f1iwq2/Tetra_Link_boardIWQ/README.md

# Tetra_Link_boardIWQ
 Tetra board for the Pi Svxlink-tetra
 Kicad Electronic Schematics & documentation
 
 Carte Tetra pour le Pi
 Schémas Kicad & documentation
 
 image::interface_MTM800E_V4.jpg[]
