f1iwq2/Tetra_Link_boardIWQ/Doc/assembly tetralink board V4 instr.pdf

## SVXLINK TETRA LINK V4 F1IWQ 31/08/2021 board assembly instructions

This card is intended for the Raspberry Pi3B+ running with the svxlink software. It interfaces the Motorola TETRA MTM800(E) or MTM5x00 radio stations series. It allows dialogs using RS232 operating mode with the MTM. The SQ (COS) signal from the MTM800 can be picked up inside the station, or be fetched by AT commands using the UART of the Pi. For this feature, you must use the tetra-contrib branch from DL1HRC. The board has a speaker terminal block for the MTM and a speaker terminal block for listening locally the radio and the audio network channels. The board is double-sided screen-printed and metallized holes, with a double ground plane.

## Description of terminal blocks, jumpers and settings

J2.1 = TxAud is the audio signal from the sound card from the pi to the sound input to the station J2.2 = RxAud is the audio signal from the radio to the sound card to the pi (mic)
J2.3 = 0V
J2.4 = NC
J2.5 = Squelch from the radio. On the MTM800E, the signal must be fetched on pin 8 on the TDA (access to the GPS hatch). See note below.
J2.6 = 0V
An audio cable must be made to connect the sound card (SP-MIC) to terminal block J2. If you use the TETRA branch of svxlink and enable TETRALOGIC, you don't need to wire J2.5 (SQ)

J3: connector to MTM800 (E)

J4: routing capacitor. J4 is to be bridge with a 1µF capacitor between 1-2 or between 2-3 depending on the impedance (level) of the audio signal injected into the radio. Normally, you have to use an external sound card with the raspberry plugged into one of its USB ports ; J4.2 and J4.3 are bridged together (use EXTMICAUD). See note at the end.

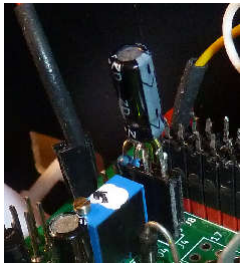
[picture p62: figure]

Capacitor soldered on pinout J4.2 and J4.3. A capacitor is required to avoid grounding bias from MTM radio through the RV1 resistor.

6 and J7: routing for UART from MTM800 / 5X00 (Rx and Tx) to Raspberry or DB9.
These two end-pins are used to route the signals from the UARTs of the MTM800 / MTM5x00 to the raspberry or the DB9.

For an MTM800E, place a jumper on J6.3 and J6.4 and a strap on J7.3 and J7.4 to redirect the UART to the raspberry pi, to be used with SVXLINK.

For an MTM5x00, this depends on the control head (control head connected to the station) see paragraph Specific features for the PEI interface using MTM5x00 on page 5.

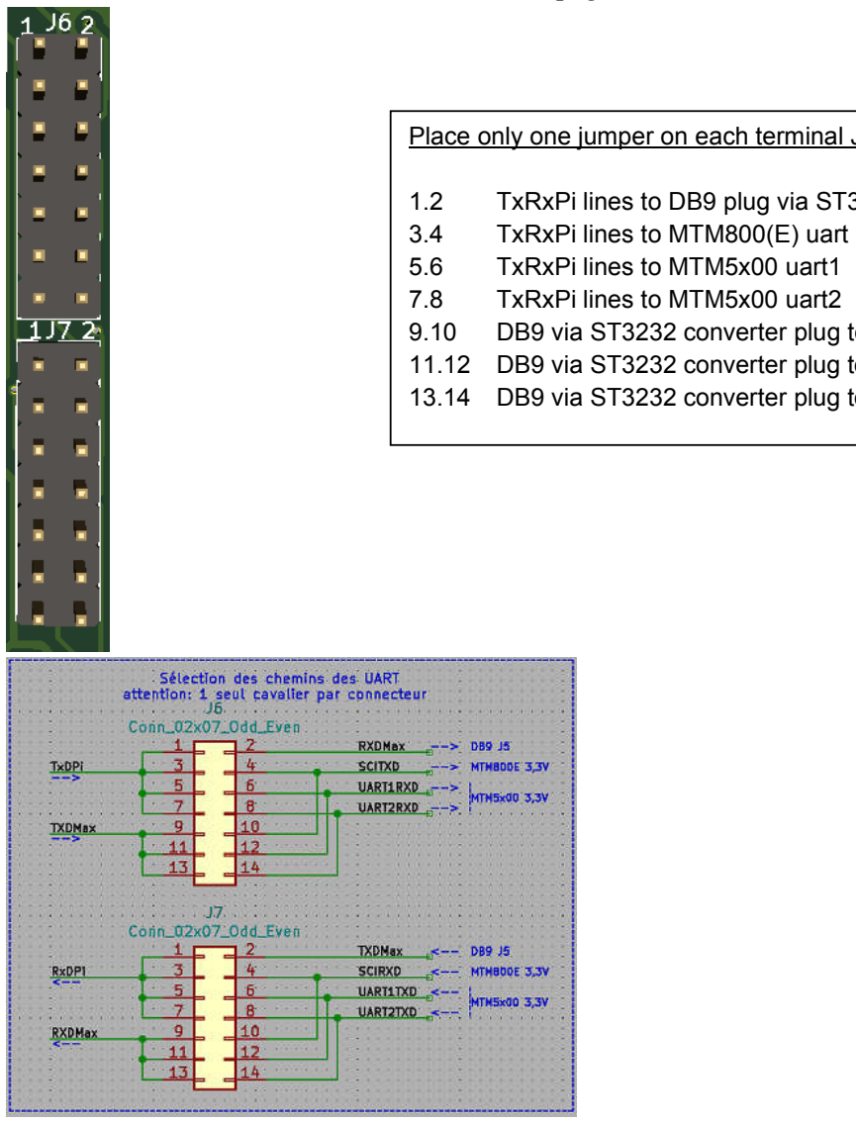
[picture p63: figure]
TxRxPi lines to MTM800(E) uart; TxRxPi lines to MTM5x00 uart1; TxRxPi lines to MTM5x00 uart2

You must not both connect an MTM800 and an MTM5x00 to the interface. Connect only one jumper per terminal J6/J7.

The MTM800 only has one UART. It can be redirected to the DB9 front face or to the raspberry. The MTM5x00 has 2 UARTs.

Please read the specific part for MTM5x00

Place only one jumper on each terminal J6/J7

1.2 | TxRxPi lines to DB9 plug via ST3232 converter
9.10 | DB9 via ST3232 converter plug to MTM800(E)
11.12 DB9 via ST3232 converter plug to MTM5x00 uart1 13.14 DB9 via ST3232 converter plug to MTM5x00 uart1

J8: pin to pin straight connector to the MTM5400

J9: bridge J9 (DTR-DSR bridge) to use the RS232 DB9 interface.

J10 and J11: see JP1 and JP2

J12: used to supply the raspberry with 5V instead of going through the usb power supply to the raspberry. Beware of the polarity.

J13 (HP-MTM) is the listening speaker of the MTM800-5x00 (HP + HP-)

J14, if it not bridged then disables the keyer to the MTM using EXTERNAL_PTT. To bridge if using a MTM5x00 in DMO repeater mode. Restriction : on the MTM5x00, if the DMO Repeater mode is used, it is not possible to use the PEI interface to key the transmiter on. You must use the PTT wired via GPIO16 and modify the Rx section accordingly.

J15 (HP1) is a terminal block for a speaker listening locally from the radio or the network.

J16 (ignition) to be connected to external 12V to automatically start the MTM as soon as the power is switched on. Switching this pin to 0V will turn off the MTM. This pin is therefore to be connected to the general 12V power supply.

J17 : RTS signal from UART1 to the MTM5x00 connector.

JP1: bridge JP1 to connect the PTT to GPIO16 of the raspberry.
Otherwise PTT is available on J10: solder a wire between J10 and the desired GPIO of the pi.

JP2: bridge JP2 to connect SQ3 (COS) to GPIO19 of the raspberry
Otherwise SQ3 is available on J11: solder a wire between J11 and the desired GPIO of the pi.

RV1: adjustment of the audio injected into the radio
RV2: adjustment of the audio received from the radio to the sound card
RV3: adjustment of the voltage switching point for the comparator LM311 (adjust to have 8.25V on terminal 3 of U1). This voltage is used to switch if the squelch signal goes from 4.5V to 12V: U1.7 = 3V if U1.2 = 12V RV4: setting from the sound card audio output (network monitoring) to the local monitoring speaker on terminal block J15
RV5: audio adjustment for the audio output from the MTM (radio listening) to the speaker of the local listening on terminal block J15.

The DB9 is in the RS232 standard; it is used in operating mode (AT commands)

Cable made for SVXLINK board to MTM800E (J3) or MTM5x00 (J6)
You just need to make a straight cable. You can also use an HE10 20/26 points straight female-female ribbon. Pay attention to the direction of the connector when plugin. For MTM5x00 depending of the front head connected to the body station, you don't need the PEI signal lines on the J6 terminal. See below.

Using RS232
The RS232 serial link allows to use the AT commands when the MTM is running. The default settings are 9600 bauds, no parity, 1 start bit 1 stop bit, without RTS / CTS protocol according to the CPS settings. You can use an RS232 / USB converter to the PC.

Note: to manage the squelch signal, it is possible to use the MTM AT commands controlled from the Pi, using a software function.

## Specific features for the PEI interface using MTM5x00 series

The PEI interfaces for MTM5x00 stations series are routed either to the rear connector or to a DB9 depending on the "control head" connected to the station.

### MTM5200 and MTM5400

If the station body (brick) is connected to a PMLN4904 "control head", then the PEI interface is available on the rear connector. It is at the 3.3V level. Use direct link on the board.

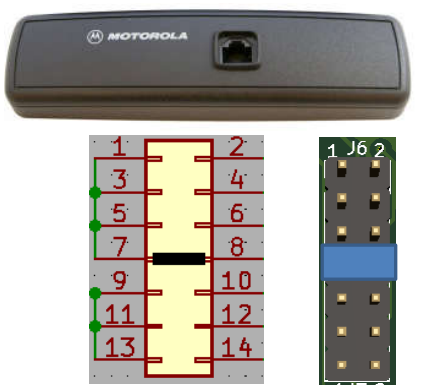
[picture p64: figure]

If the station body (brick) is connected to a PMLN4908 "data expansion head", then the PEI interface is redirected to the front DB9 on the data expansion head. (MTM5500). It complies with RS232 V24 standards and can be connected to a serial COM port to a PC directly.

Control head
PMLN4904

Strap position for
J6 et J7:
J6.7 - J6.8
J7.7 - J7.8
Using UART2

Data expansion head
PMLN4908

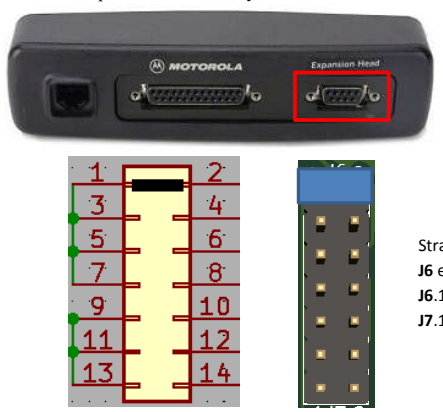
[picture p65: figure]

Strap position for
J6 et J7 :
J6.1 - J6.2
J7.1 - J7.2

## MTM5500

The station body (brick) is to be connected to an "ethernet expansion control head" PMLN7009 and the PEI interface is redirected to the front DB9 on the ethernet remote control head. It complies with RS232 V24 standards and can be connected to a COM port to a PC directly.

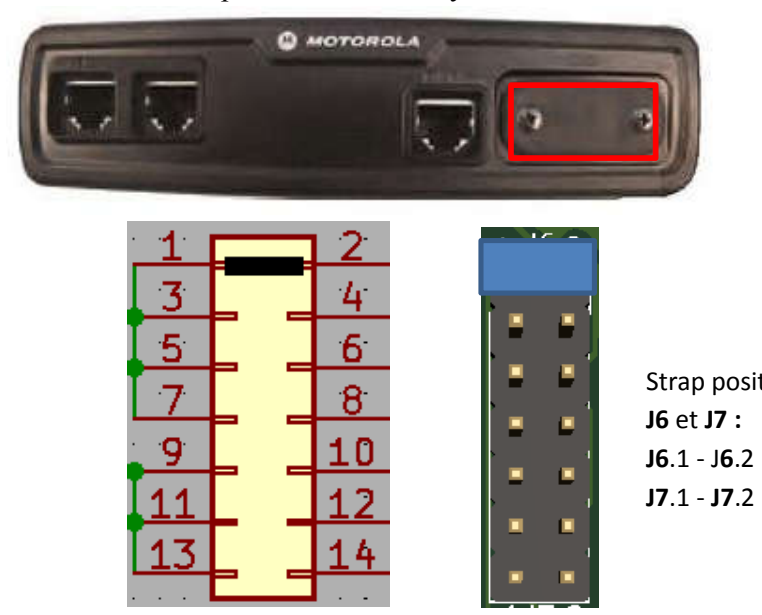
[picture p66: figure]

To link the TetraLink board, you need to use a RS232 cross cable from the DB9 from the data expansion head (MTM5400) or from the Ethernet expansion head (MTM5500) to the DB9 (J5) tetralink board, for the PEI connection. Does not apply to MTM800E.

Ethernet expansion
control head
PMLN7009

Strap position for

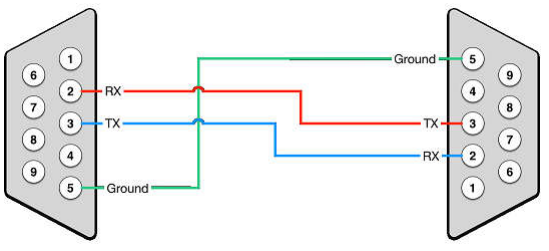
[picture p67: figure]

### Straight cable to MTM5200 MTM5400 pmln4908 or MTM5500

Use this cable between :
- J8 conn – 26pin radio conn. and :
- MTM5200/ MTM5400 + control head PMLN4904
- MTM5400 + data expansion head pmln4908
- MTM5500 + ethernet expansion control head.
1 | 2
3 | 4
5 | 6
7 | 8
9 | 10
11 | 12
13 | 14
15 | 16
17 | 18
19 | 20
21 | 22
23 | 24
25 | 26

Pin numbers are from motorola connector.

The serial link comes from the DB9 connector on the data expansion head / ethernet expansion control head.

Red links are only for MTM 5200 and 5400 with PMLN4904, strap 7 & 8 for both J6 et J7.

SWB+

HP+

HP-

TxAudio

0V

Ext_Mic

RxAudio

PTT

Ignition

UART2TXD

UART2RXD

### Straight cable to a MTM800(e)

Use this cable between :
- J3 board conn – 20pin radio conn. and MTM800(e)
1 | 2
3 | 4
5 | 6
7 | 8
9 | 10
11 | 12
13 | 14
15 | 16
17 | 18
19 | 20

Les numéros de broches sont les numéros de broches motorola

Pin numbers are from motorola connector.

SWB+

HP+

HP-

TxAudio

0V

Ext_Mic

RxAudio

PTT

Ignition

SCIRXD

SCITXD

## Components list, values and footprints

C1,C2 | 10µF | Capacitor_THT:CP_Radial_D5.0mm_P2.50mm
C10,C11 | 100nF | Capacitor_THT:C_Rect_L7.0mm_W2.5mm_P5.00mm
C12,C13 | 10µF | Capacitor_THT:CP_Radial_D4.0mm_P2.00mm
C14 | 4,7µF | Capacitor_THT:CP_Radial_D4.0mm_P2.00mm
C3,C4,C5,C6,C7 | 100nF | Capacitor_SMD:C_0805_2012Metric
C8,C9,C15,C16, C17 | 1µF | Capacitor_THT:CP_Radial_D4.0mm_P2.00mm
D1,D2,D3 | LED | LED_THT:LED_D3.0mm
D4 | 1N4004 | Diode_THT:D_A-405_P5.08mm_Vertical_AnodeUp
J1 | Raspberry_Pi3B+ | Raspberry-Pi-3-library-for-kicad-master:raspberrypi2
J10,J11,J16 | Conn_01x01 | TestPoint:TestPoint_Loop_D2.50mm_Drill1.0mm
J12,J13,J15 | Screw_Terminal_01x02 | TerminalBlock:TerminalBlock_bornier-2_P5.08mm
J2 | Conn_01x01_Male | Connector_PinHeader_2.54mm:PinHeader_1x06_P2.54mm_Vertical
J3 | Conn_02x10_Odd_Even | Connector_PinHeader_2.54mm:PinHeader_2x10_P2.54mm_Vertical
J4, J6,J7 | Conn_01x03 Conn_02x06 | Connector_PinHeader_2.54mm:PinHeader_1x03_P2.54mm_Vertical Connector_PinHeader_2.54mm:PinHeader_2x06_P2.54mm_Vertical
J5 | DB9_Female | Connector_Dsub:DSUB-9_Female_Horizontal_P2.77x2.84mm_EdgePinOffset9.90mm_Housed_ MountingHolesOffset11.32mm
J8 | Conn_02x13_Odd_Even | Connector_PinHeader_2.54mm:PinHeader_2x13_P2.54mm_Vertical
J9,J14 | Conn_01x02 | Connector_PinHeader_2.54mm:PinHeader_1x02_P2.54mm_Vertical
JP1,JP2 | Jumper_2_Bridged | Jumper:SolderJumper-2_P1.3mm_Open_TrianglePad1.0x1.5mm
Q1,Q2 | BC548 | Package_TO_SOT_THT:TO-92_Inline_Wide
R10 | 10k | Resistor_THT:R_Axial_DIN0204_L3.6mm_D1.6mm_P2.54mm_Vertical
R13 | 47k | Resistor_THT:R_Axial_DIN0207_L6.3mm_D2.5mm_P7.62mm_Horizontal
R14 | 100k | Resistor_THT:R_Axial_DIN0204_L3.6mm_D1.6mm_P2.54mm_Vertical
R15 | 100k | Resistor_THT:R_Axial_DIN0207_L6.3mm_D2.5mm_P7.62mm_Horizontal
R16 | 600 | Resistor_THT:R_Axial_DIN0207_L6.3mm_D2.5mm_P7.62mm_Horizontal
R18 | 4,7k | Resistor_THT:R_Axial_DIN0207_L6.3mm_D2.5mm_P7.62mm_Horizontal
R3 | 4.7k | Resistor_THT:R_Axial_DIN0207_L6.3mm_D2.5mm_P7.62mm_Horizontal
R1,R2,R4,R17 | 1,2k | Resistor_THT:R_Axial_DIN0207_L6.3mm_D2.5mm_P7.62mm_Horizontal
R5 | 10k | Resistor_THT:R_Axial_DIN0207_L6.3mm_D2.5mm_P7.62mm_Horizontal
R6,R7 | 330 | Resistor_THT:R_Axial_DIN0207_L6.3mm_D2.5mm_P7.62mm_Horizontal
R8,R11,R12 | 1k | Resistor_THT:R_Axial_DIN0204_L3.6mm_D1.6mm_P2.54mm_Vertical
R9 | 1k | Resistor_THT:R_Axial_DIN0207_L6.3mm_D2.5mm_P2.54mm_Vertical
RV1,RV2 | 47k | Potentiometer_THT:Potentiometer_Bourns_3296W_Vertical
RV3 | 10k | Potentiometer_THT:Potentiometer_Bourns_3296W_Vertical
RV4,RV6 | 47K | Potentiometer_THT:Potentiometer_Bourns_3296W_Vertical
U1 | LM311 | Package_DIP:DIP-8_W7.62mm_LongPads
U2 | ST3232 | Package_SO:SOIC-16_3.9x9.9mm_P1.27mm
U3 | LD1117AV33 | Package_TO_SOT_THT:TO255P1020X450X1968-3
U4 | TL074 | Package_SO:SOIC-14_3.9x8.7mm_P1.27mm
U5 | L78L05_TO92 | Package_TO_SOT_THT:TO-92L_Inline_Wide
U6 | LMC7660 | Package_SO:SOIC-8_3.9x4.9mm_P1.27mm
U8 | LM386 | Package_DIP:DIP-8_W7.62mm_LongPads

First, start soldering the SMDs (U2 U4 U6 and the SMD capacitors). Applying welding flux before soldering helps to ensure excellent results, clean with isopropylic alcohol or flux solvent after soldering.

There is a serigraphy error on the anode position for D4; position A is correct on the layout plan below.

The 2x20 pin GPIO connector of the raspberry is to be soldered on the opposite face to the components. For the V4 card, it is necessary to use a high profile 15mm connector, so that the V4 card overhangs the USB and Ethernet ports of the raspberry. Be careful when positioning, use spacers to sufficiently release the USB and Ethernet plugs from the pi. Do not solder the plate when it is against the connector but raised by a few millimeters to release the ethernet socket of the raspberry. The solder of this connector is to be done pluged into the GPIO of the pi and spacers in place. It is not necessary to cut the pins, this makes it possible to connect a stop button to control the pi, for example.

Kit ici : https://www.amazon.fr/Nrpfell-DEmpilage-Extra-Haut-Acrylique-Raspberry/dp/B08H5H6JGP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
Ou
https://www.ebay.fr/itm/Gpio-Tete-Raspberrypi-Un-B-Pi-2-Pi-3-3B-4B-Grand-2x20-Femelle-Tete-/253520834066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

U3 can be replaced by a 78L33 (100mA), if you twist its legs for its adaptation.

On the layout diagram, the square pads always shows pin 1 of a circuit (except for SMDs whose pin 1 is marked by the upper line shifted to the left)

Be careful when supplying the female DB9, there are several footprints. The reference below is correct. https://fr.rs-online.com/web/p/connectors-sub-d/2395855/

Beware, the chassis of U3 is at potential 3.3V! You can set an insulating tape on the frame to avoid accidental short circuits.

## Implantation

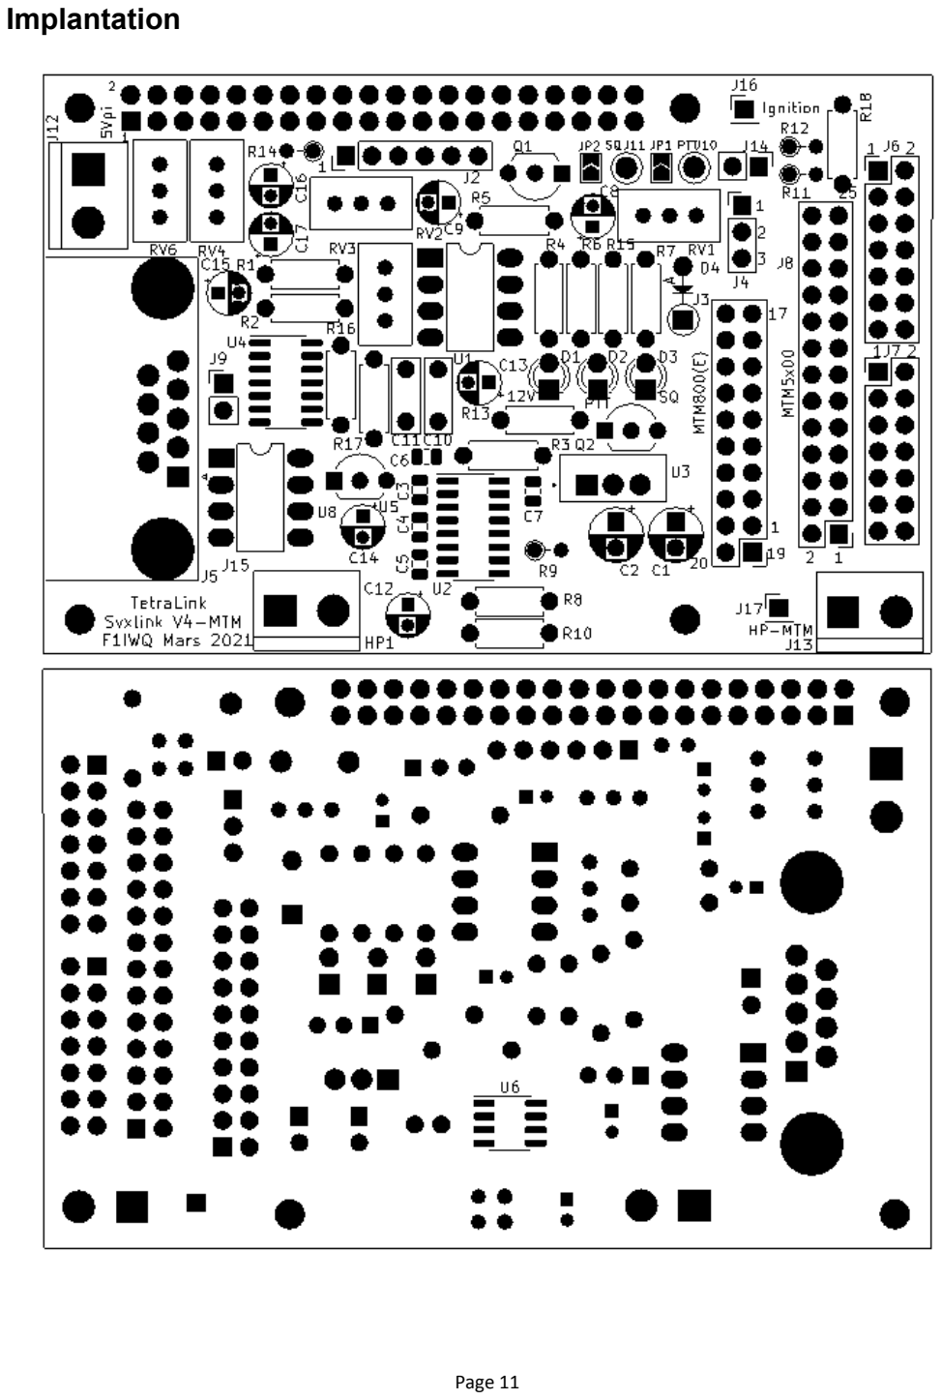
[picture p68: page 11]

## 3D view


## Photos


## Audio circuit

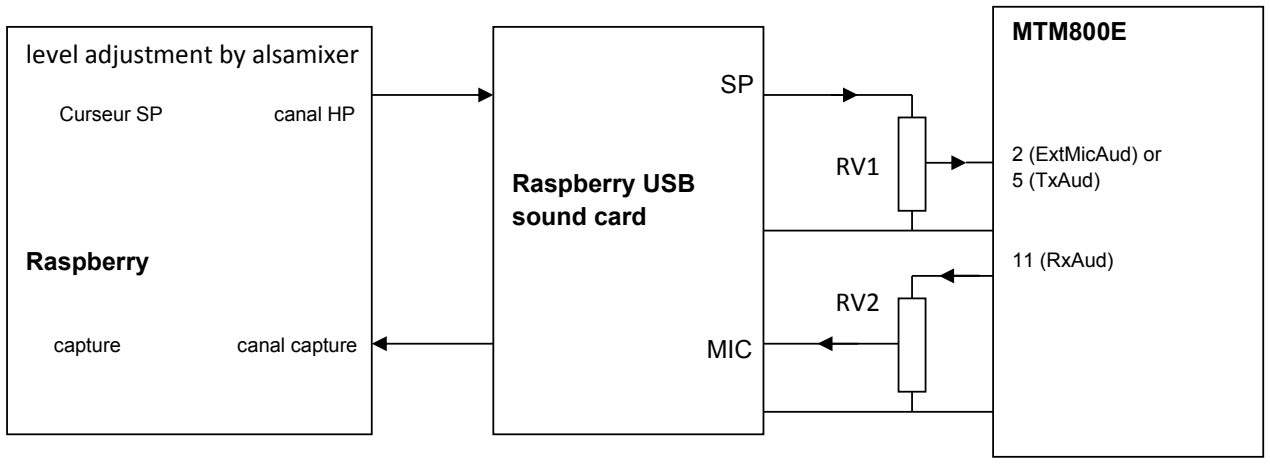
[picture p69: figure]
Raspberry USB sound card; MIC; MTM800E; 2 (ExtMicAud) or 5 (TxAud); 11 (RxAud); level adjustment by alsamixer; Curseur SP; canal HP; Raspberry; capture; canal capture

If the sound card has terminal socket jacks, it is strongly recommended to directly solder the wires on the sound card because of the bad contacts of the jacks.

In Alsamixer, automute control must be muted (type m with automute control enabled)

The external USB sound card used. For reliability problems of the jack connectors, directly solder the audio wires to the sound card

## Pi integration

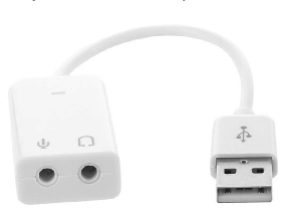
[picture p70: figure]

It is necessary to choose spacers high enough to free the board of the card from the metallic Ethernet / USB connectors of the raspberry. The thread of the spacers is 2.5 mm.

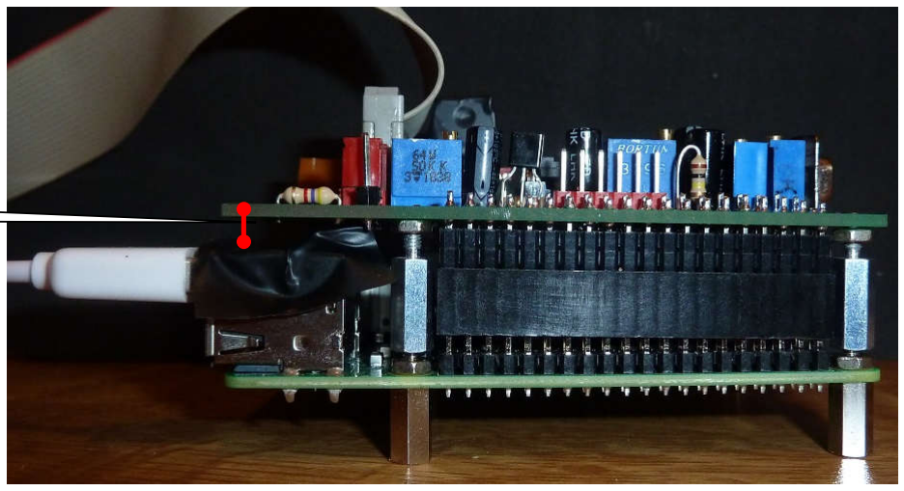
[picture p71: figure]

5mm

## Codeplug Parameters

To take into account microphone input 1 (pin 13) of the MTM5500: set the following parameters:


The Ext Speaker Rear Accry setting is not required.

## DMO Repeater restriction

In DMO repeater mode (AT+CTOM=6), motorola radios are not able to transmit using the PEI AT command. A transmission incoming from network will not be radio broadcasted. The restriction must be bypassed by using the wired PTT.

## Wiring board

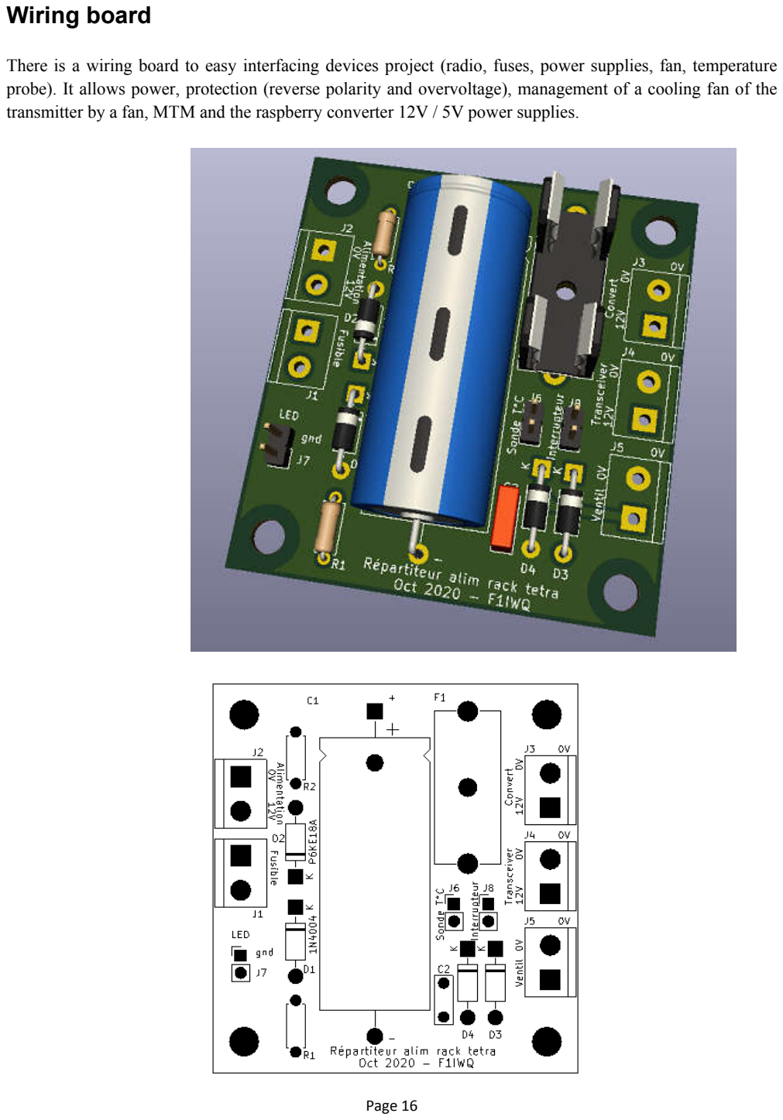
[picture p72: page 16]

There is a wiring board to easy interfacing devices project (radio, fuses, power supplies, fan, temperature probe). It allows power, protection (reverse polarity and overvoltage), management of a cooling fan of the transmitter by a fan, MTM and the raspberry converter 12V / 5V power supplies.

D1 D3 D4 | 1N4004 | Diode
D2 | P6KE18A | Diode transil 18V
C1 | 2200 µF 18V mini | Radial (pas 7,6 mm) ou axial (pas 48 mm)
R1 | 1,2 kΩ
R2 | 10 kΩ
F1 | Support fusible à souder | Pour fusible 5x20 2A
C2 | 100 nF plastique
J1 J2 J3 J4 | Bornier pas de 2,54 mm | Grande section de câble
J6 J7 J8 | Bornier HE10
Led | Présence tension | Externe
Sonde de température | KSD9700 45°C NO or 40°C… | Externe – normalement ouvert
Ventilateur | 12V | Externe

The temperature probe for "dry contact" type is normally opened at 20°C and closes at 40°C. It must be inserted in the fins of the heatsink of the transmitter and glued with neoprene glue.

J1 is the terminal block to the front panel fuse. J3 is the terminal block towards the converter 12V 5V 3A power supply for the pi (Ref CPT)

There are 2 GND drills on the board for either a radial or an axial capacitor C1.

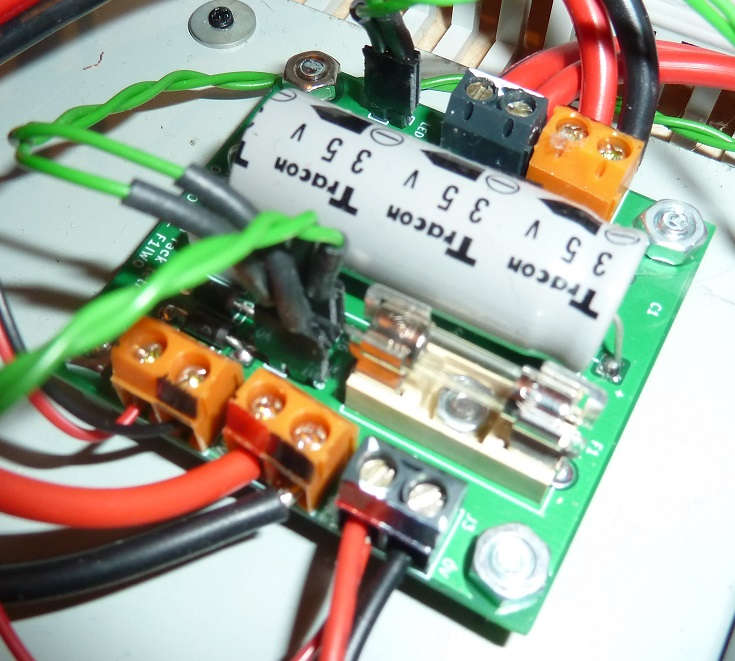
[picture p73: figure]
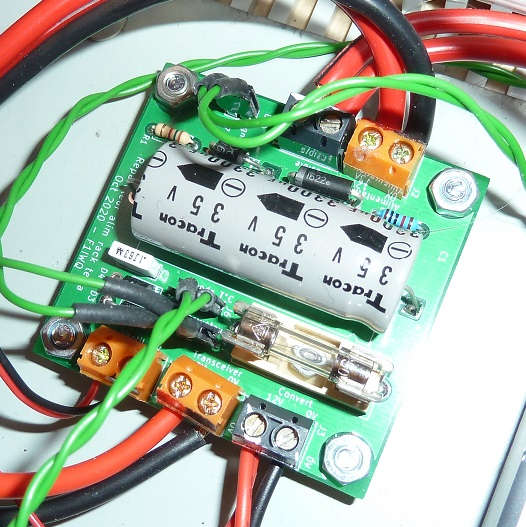
[picture p74: figure]
