f1iwq2/Tetra_Link_boardIWQ/Printing Impression Schématique.pdf

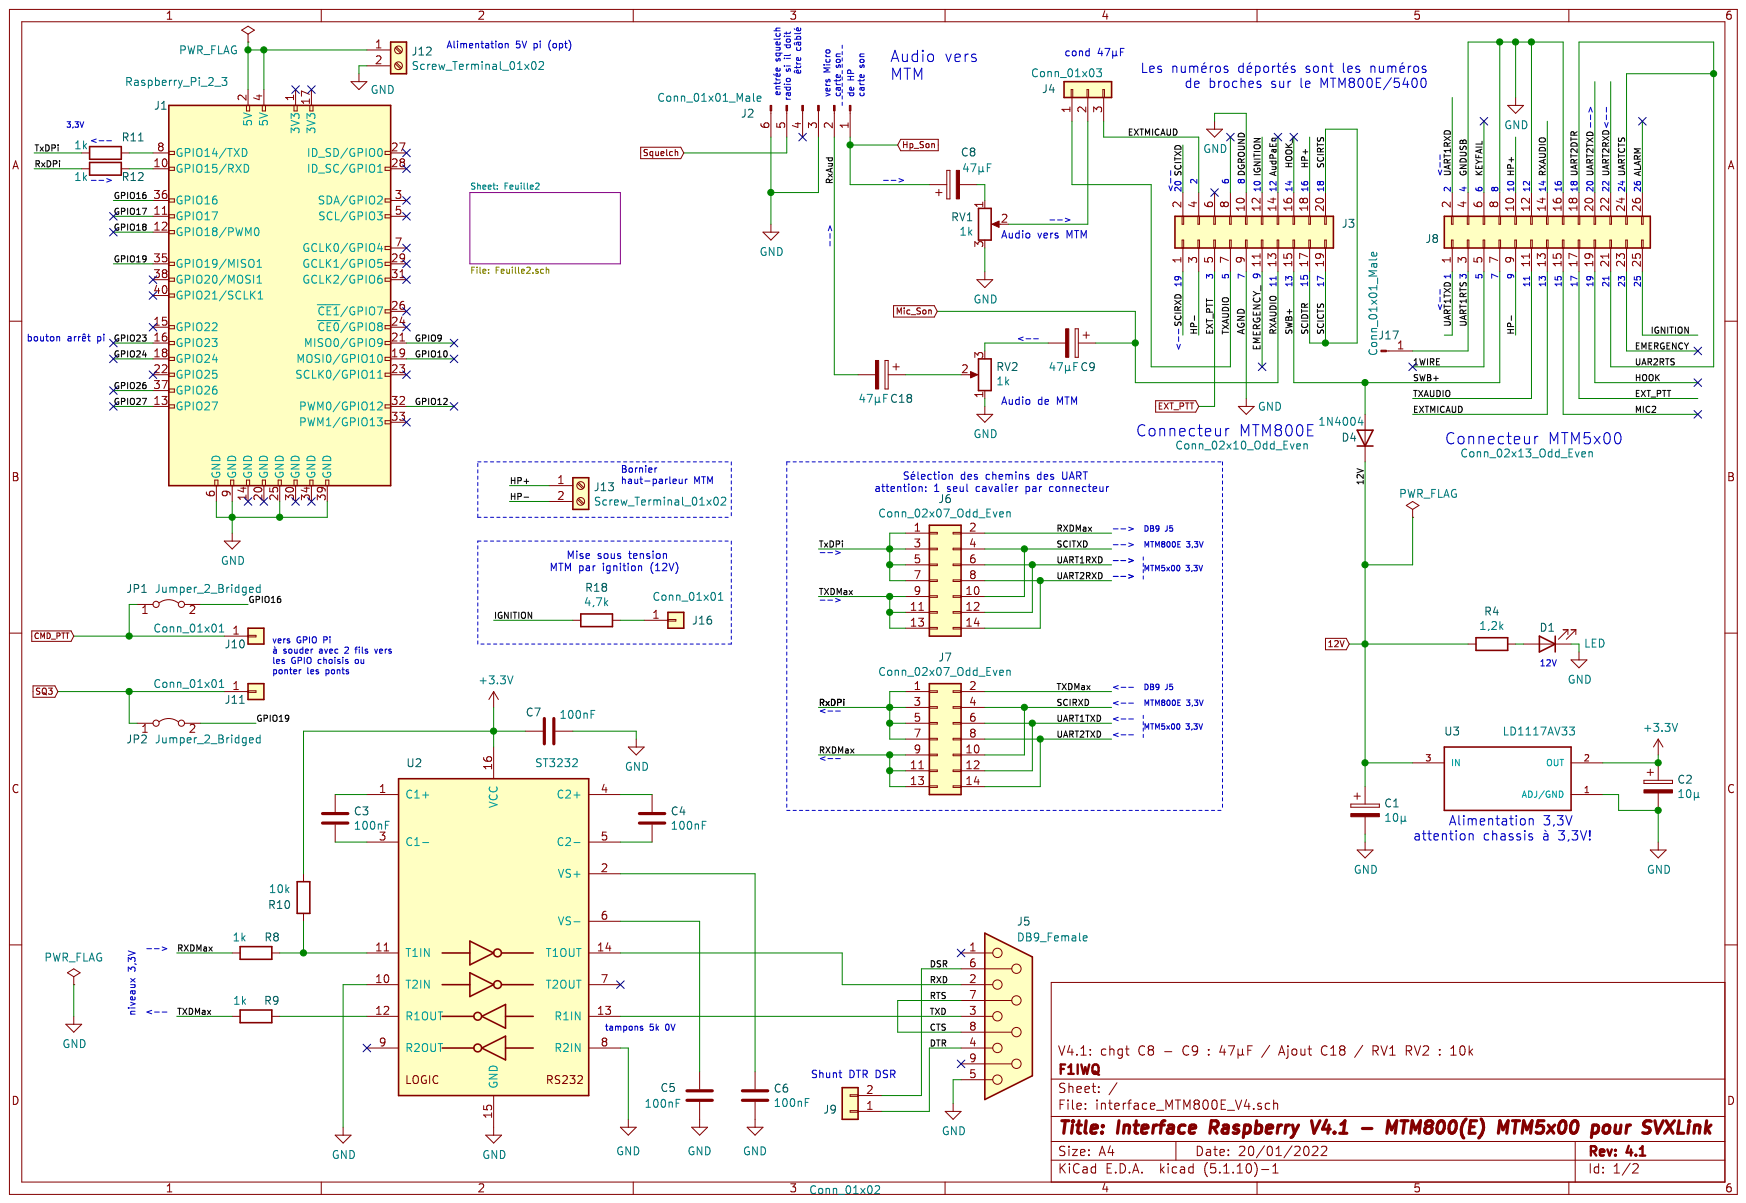
[picture p78: page 1]

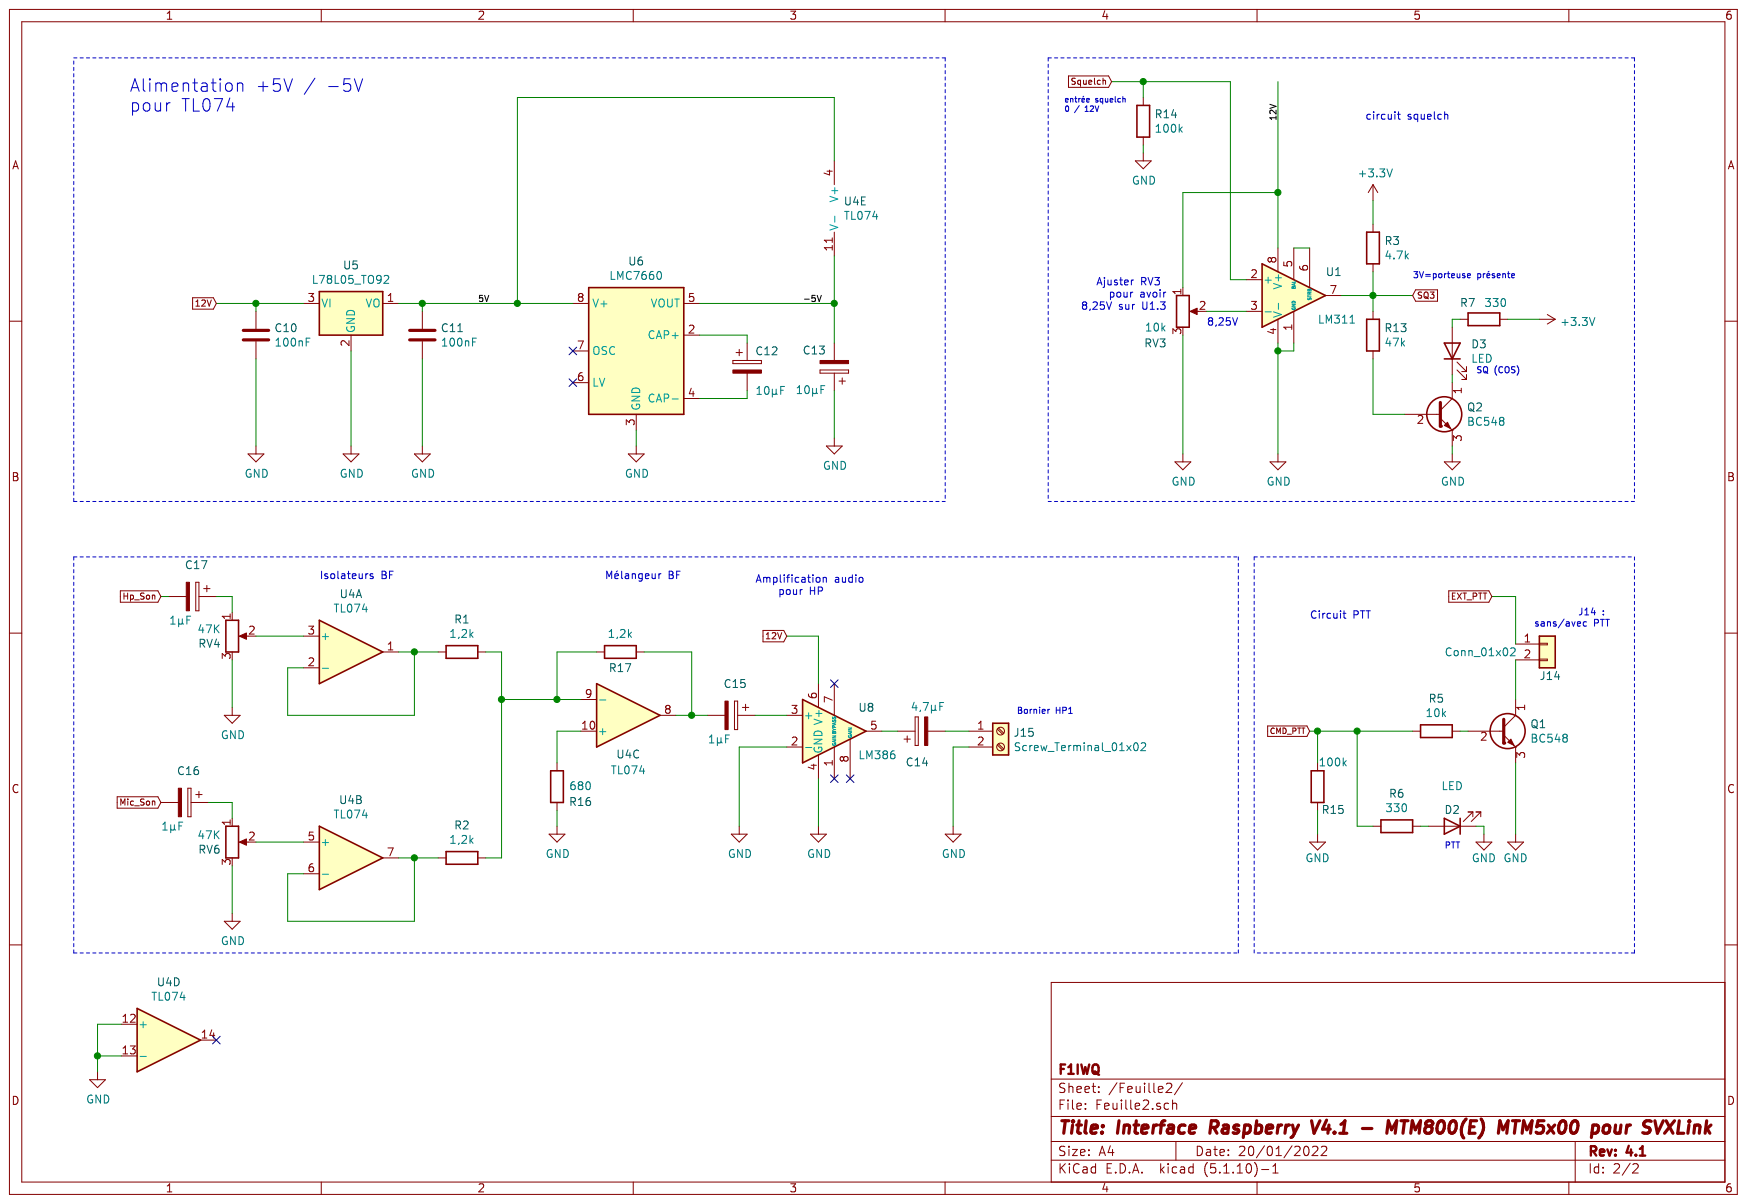
[picture p79: page 2]
