f1iwq2/Tetra_Link_boardIWQ/interface_MTM800E_V4.kicad_pcb

## KiCad design interface_MTM800E_V4.kicad_pcb (2022-04-17)

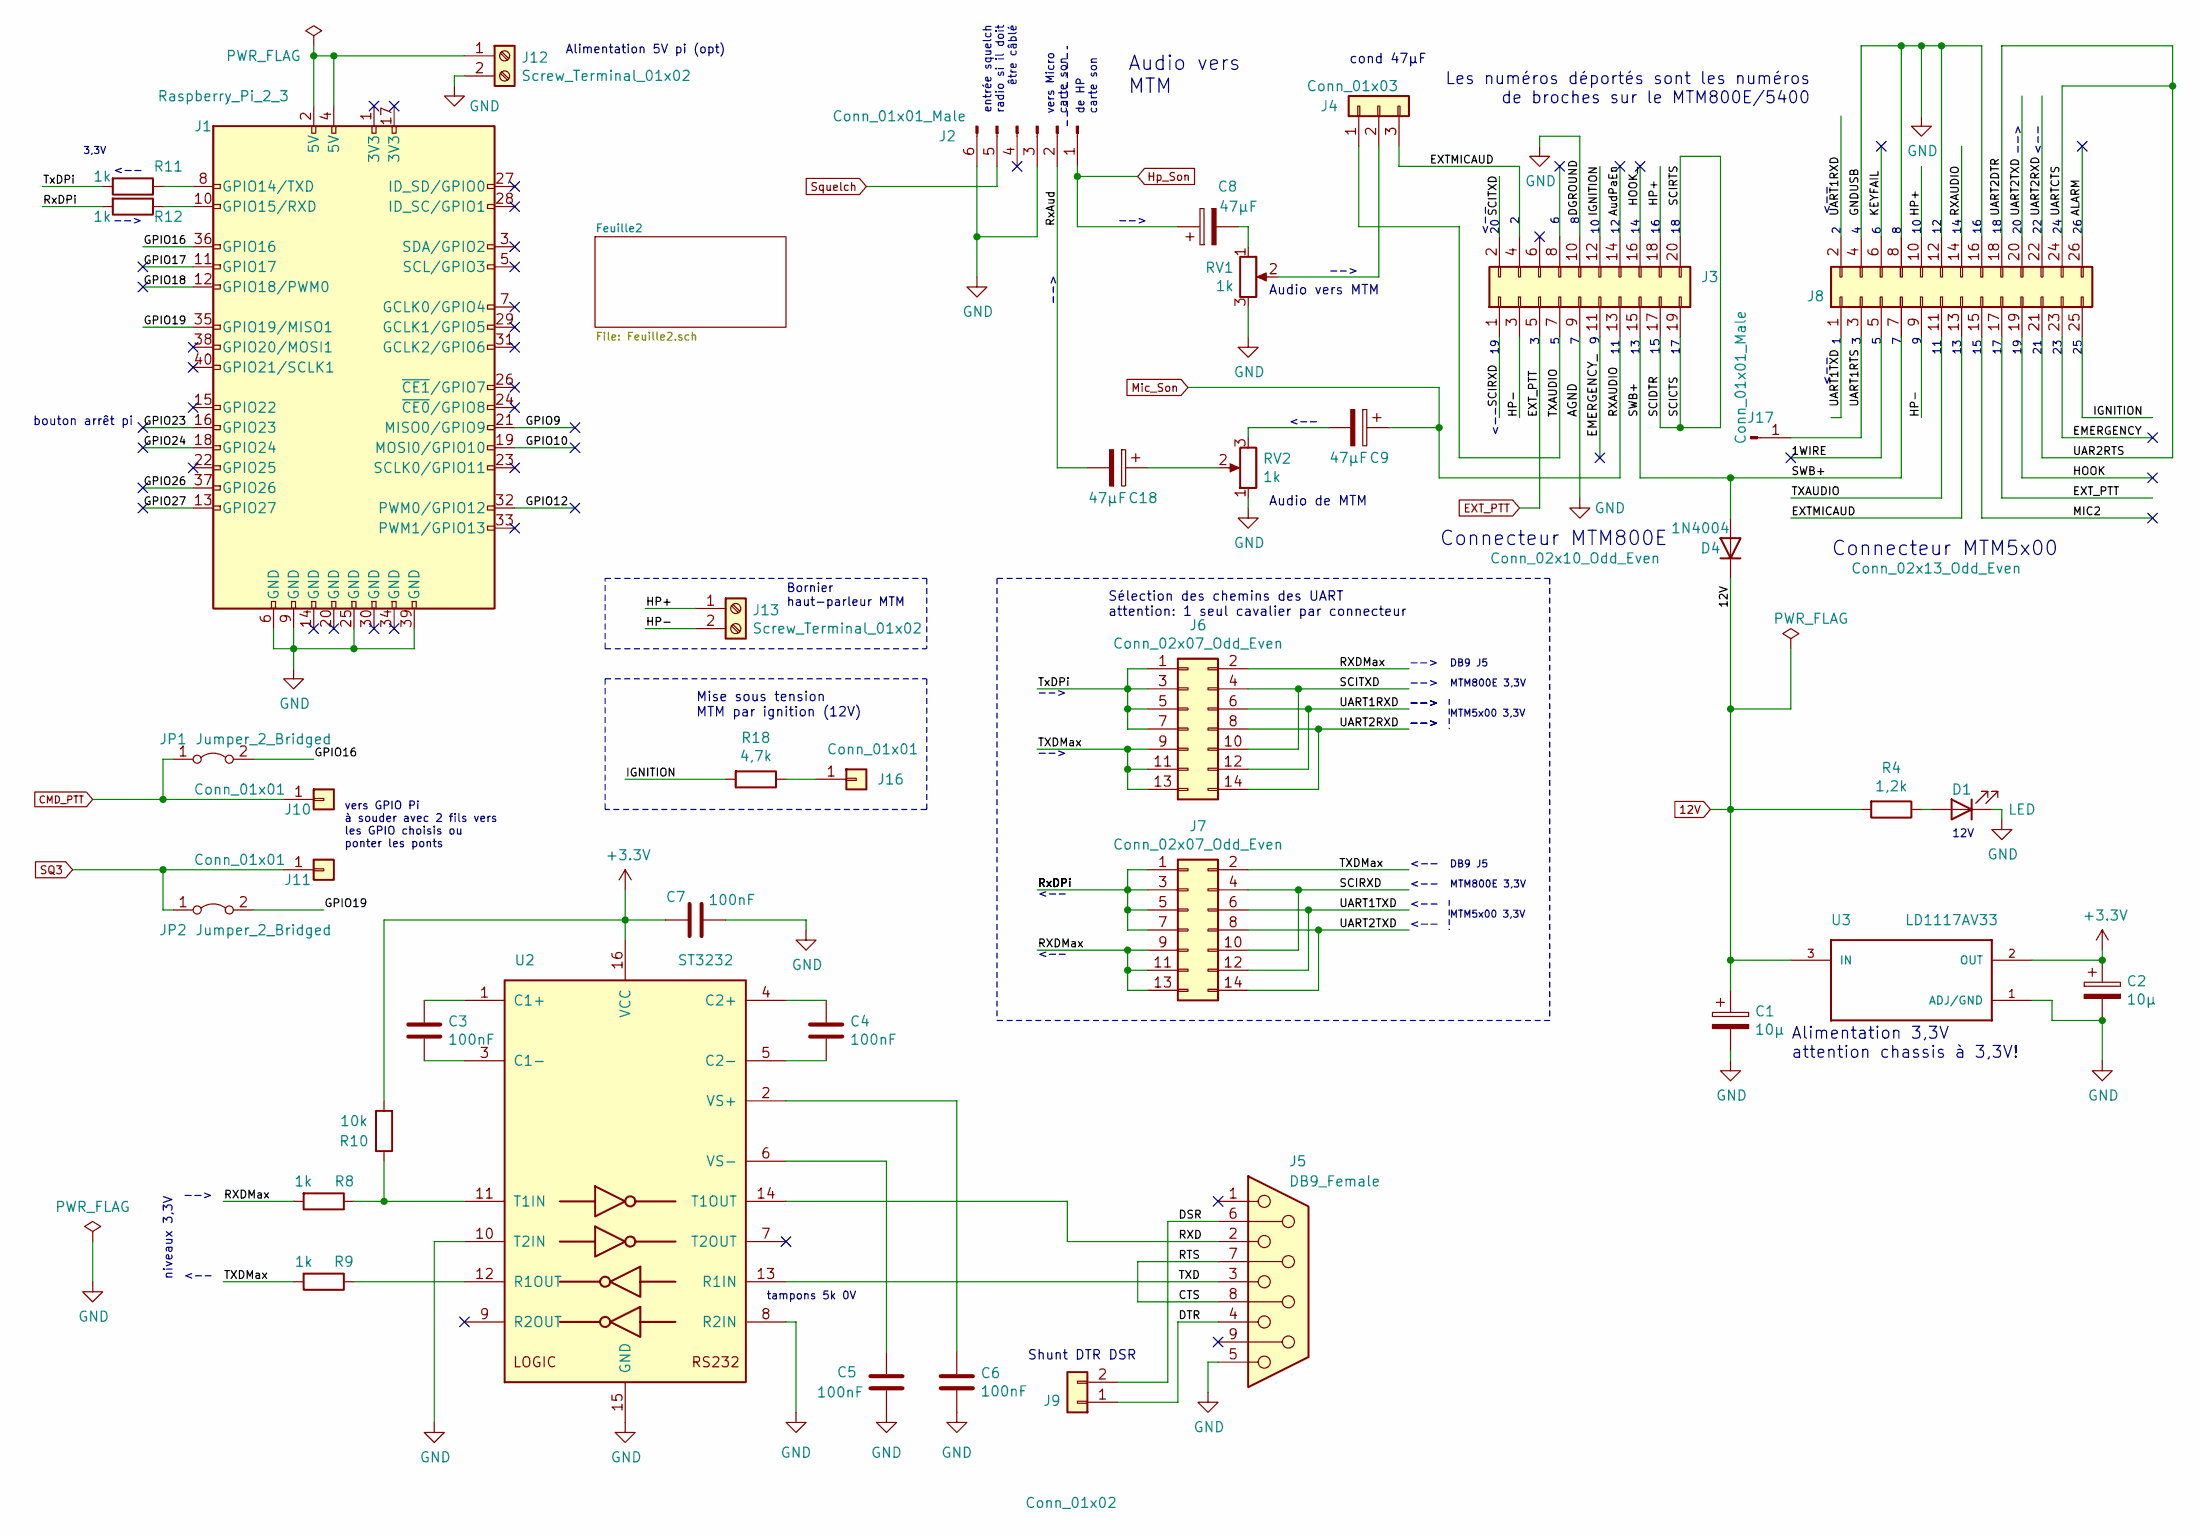
[picture p80: schematic interface_MTM800E_V4.sch, Interface Raspberry V4.1 - MTM800(E) MTM5x00 pour SVXLink]

Parts:
C1, C2: 10µ; CP_Radial_D5.0mm_P2.50mm
C3, C4, C5, C6, C7: 100nF; C_0805_2012Metric
C8, C9, C18: 47µF; CP_Radial_D4.0mm_P2.00mm
D1: LED; LED_D3.0mm
D4: 1N4004; D_A-405_P5.08mm_Vertical_AnodeUp
J1: Raspberry_Pi_2_3; raspberrypi2
J2: Conn_01x01_Male; PinHeader_1x06_P2.54mm_Vertical
J3: Conn_02x10_Odd_Even; PinHeader_2x10_P2.54mm_Vertical
J4: Conn_01x03; PinHeader_1x03_P2.54mm_Vertical
J5: DB9_Female; DSUB-9_Female_Horizontal_P2.77x2.84mm_EdgePinOffset9.90mm_H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
J6, J7: Conn_02x07_Odd_Even; PinHeader_2x07_P2.54mm_Vertical
J8: Conn_02x13_Odd_Even; PinHeader_2x13_P2.54mm_Vertical
J9: Conn_01x02; PinHeader_1x02_P2.54mm_Vertical
J10, J11: Conn_01x01; TestPoint_Loop_D2.50mm_Drill1.0mm
J12, J13: Screw_Terminal_01x02; TerminalBlock_bornier-2_P5.08mm
J16: Conn_01x01; PinHeader_1x01_P2.54mm_Vertical
J17: Conn_01x01_Male; PinHeader_1x01_P2.54mm_Vertical
JP1, JP2: Jumper_2_Bridged; SolderJumper-2_P1.3mm_Open_TrianglePad1.0x1.5mm
R4: 1,2k; R_Axial_DIN0207_L6.3mm_D2.5mm_P7.62mm_Horizontal
R8: 1k; R_Axial_DIN0207_L6.3mm_D2.5mm_P7.62mm_Horizontal
R9, R11, R12: 1k; R_Axial_DIN0204_L3.6mm_D1.6mm_P2.54mm_Vertical
R10: 10k; R_Axial_DIN0207_L6.3mm_D2.5mm_P7.62mm_Horizontal
R18: 4,7k; R_Axial_DIN0207_L6.3mm_D2.5mm_P7.62mm_Horizontal
RV1, RV2: 1k; Potentiometer_Bourns_3296W_Vertical
U2: ST3232; SOIC-16_3.9x9.9mm_P1.27mm
U3: LD1117AV33; TO255P1020X450X1968-3

Connections:
12V: C1.1, D4.1 (K), R4.2, U3.3 (IN); also elsewhere on the board
+3V3: C2.1, C7.1, R10.2, U2.16 (VCC), U3.2 (OUT); also elsewhere on the board
/1WIRE: J8.5
/ALARM: J8.26
/AudPaEn: J3.14
/CTS: J5.7, J5.8
/DSR: J5.6, J9.2
/DTR: J5.4, J9.1
/EMERGENCY: J8.23
/EMERGENCY_: J3.11
/EXTMICAUD: J3.4, J4.3, J8.13
/GPIO9: J1.21 (MISO0/GPIO9)
/GPIO10: J1.19 (MOSI0/GPIO10)
/GPIO12: J1.32 (PWM0/GPIO12)
/GPIO16: J1.36 (GPIO16), JP1.2 (B)
/GPIO17: J1.11 (GPIO17)
/GPIO18: J1.12 (GPIO18/PWM0)
/GPIO19: J1.35 (GPIO19/MISO1), JP2.2 (B)
/GPIO23: J1.16 (GPIO23)
/GPIO24: J1.18 (GPIO24)
/GPIO26: J1.37 (GPIO26)
/GPIO27: J1.13 (GPIO27)
/HOOK: J8.19
/HOOK_: J3.16
/HP+: J3.18, J8.10, J13.1
/HP-: J3.3, J8.9, J13.2
/IGNITION: J3.12, J8.25, R18.2
/KEYFAIL: J8.6
/MIC2: J8.15
/RXD: J5.2, U2.14 (T1OUT)
/RXDMax: J6.2, J7.9, J7.11, J7.13, R8.2
/RxDPi: J7.1, J7.3, J7.5, J7.7, R12.2
/SCICTS: J3.17, J3.19, J3.20
/SCIRXD: J3.1, J7.4, J7.10
/SCITXD: J3.2, J6.4, J6.10
/SWB+: D4.2 (A), J3.15, J8.7
/TXAUDIO: J3.7, J4.1, J8.11
/TXD: J5.3, U2.13 (R1IN)
/TXDMax: J6.9, J6.11, J6.13, J7.2, R9.2
/TxDPi: J6.1, J6.3, J6.5, J6.7, R11.2
/UAR2RTS: J8.18, J8.21, J8.24
/UART1RTS: J8.3, J17.1
/UART1RXD: J6.6, J6.12, J8.2
/UART1TXD: J7.6, J7.12, J8.1
/UART2RXD: J6.8, J6.14, J8.22
/UART2TXD: J7.8, J7.14, J8.20
CMD_PTT: J10.1, JP1.1 (A); also elsewhere on the board
EXT_PTT: J3.5, J8.17; also elsewhere on the board
GND: C1.2, C2.2, C5.2, C6.2, C7.2, D1.1 (K), J1.6 (GND), J1.9 (GND), J1.25 (GND), J1.39 (GND), J2.3, J2.6, J3.9, J3.10, J5.5, J8.4, J8.8, J8.12, J8.16, J12.2, RV1.3, RV2.1, U2.8 (R2IN), U2.10 (T2IN), U2.15 (GND), U3.1 (ADJ/GND); also elsewhere on the board
Mic_Son: C9.1, J3.13, J8.14; also elsewhere on the board
unnamed: C3.1, U2.1 (C1+)
unnamed: C3.2, U2.3 (C1-)
unnamed: C4.1, U2.4 (C2+)
unnamed: C4.2, U2.5 (C2-)
unnamed: C5.1, U2.6 (VS-)
unnamed: C6.1, U2.2 (VS+)
unnamed: C9.2, RV2.3
unnamed: D1.2 (A), R4.1
unnamed: J1.2 (5V), J1.4 (5V), J12.1
unnamed: J1.8 (GPIO14/TXD), R11.1
unnamed: J1.10 (GPIO15/RXD), R12.1
unnamed: J4.2, RV1.2
unnamed: J16.1, R18.1
unnamed: R9.1, U2.12 (R1OUT)
unnamed: R8.1, R10.1, U2.11 (T1IN)
SQ3: J11.1, JP2.1 (A); also elsewhere on the board
Squelch: J2.5; also elsewhere on the board

Notes on the sheet:
Connecteur MTM800E
Les numéros déportés sont les numéros de broches sur le MTM800E/5400
Audio vers MTM
Audio de MTM
niveaux 3,3V
Alimentation 3,3V attention chassis à 3,3V!
Connecteur MTM5x00
Shunt DTR DSR
vers GPIO Pi à souder avec 2 fils vers les GPIO choisis ou ponter les ponts
Alimentation 5V pi (opt)
vers Micro carte son
de HP carte son
12V
Bornier haut-parleur MTM
<--
-->
tampons 5k 0V
bouton arrêt pi
Mise sous tension MTM par ignition (12V)
Sélection des chemins des UART attention: 1 seul cavalier par connecteur
Audio vers MTM
entrée squelch radio si il doit être câblé
MTM800E 3,3V
MTM5x00 3,3V
3,3V
DB9 J5
cond 47µF

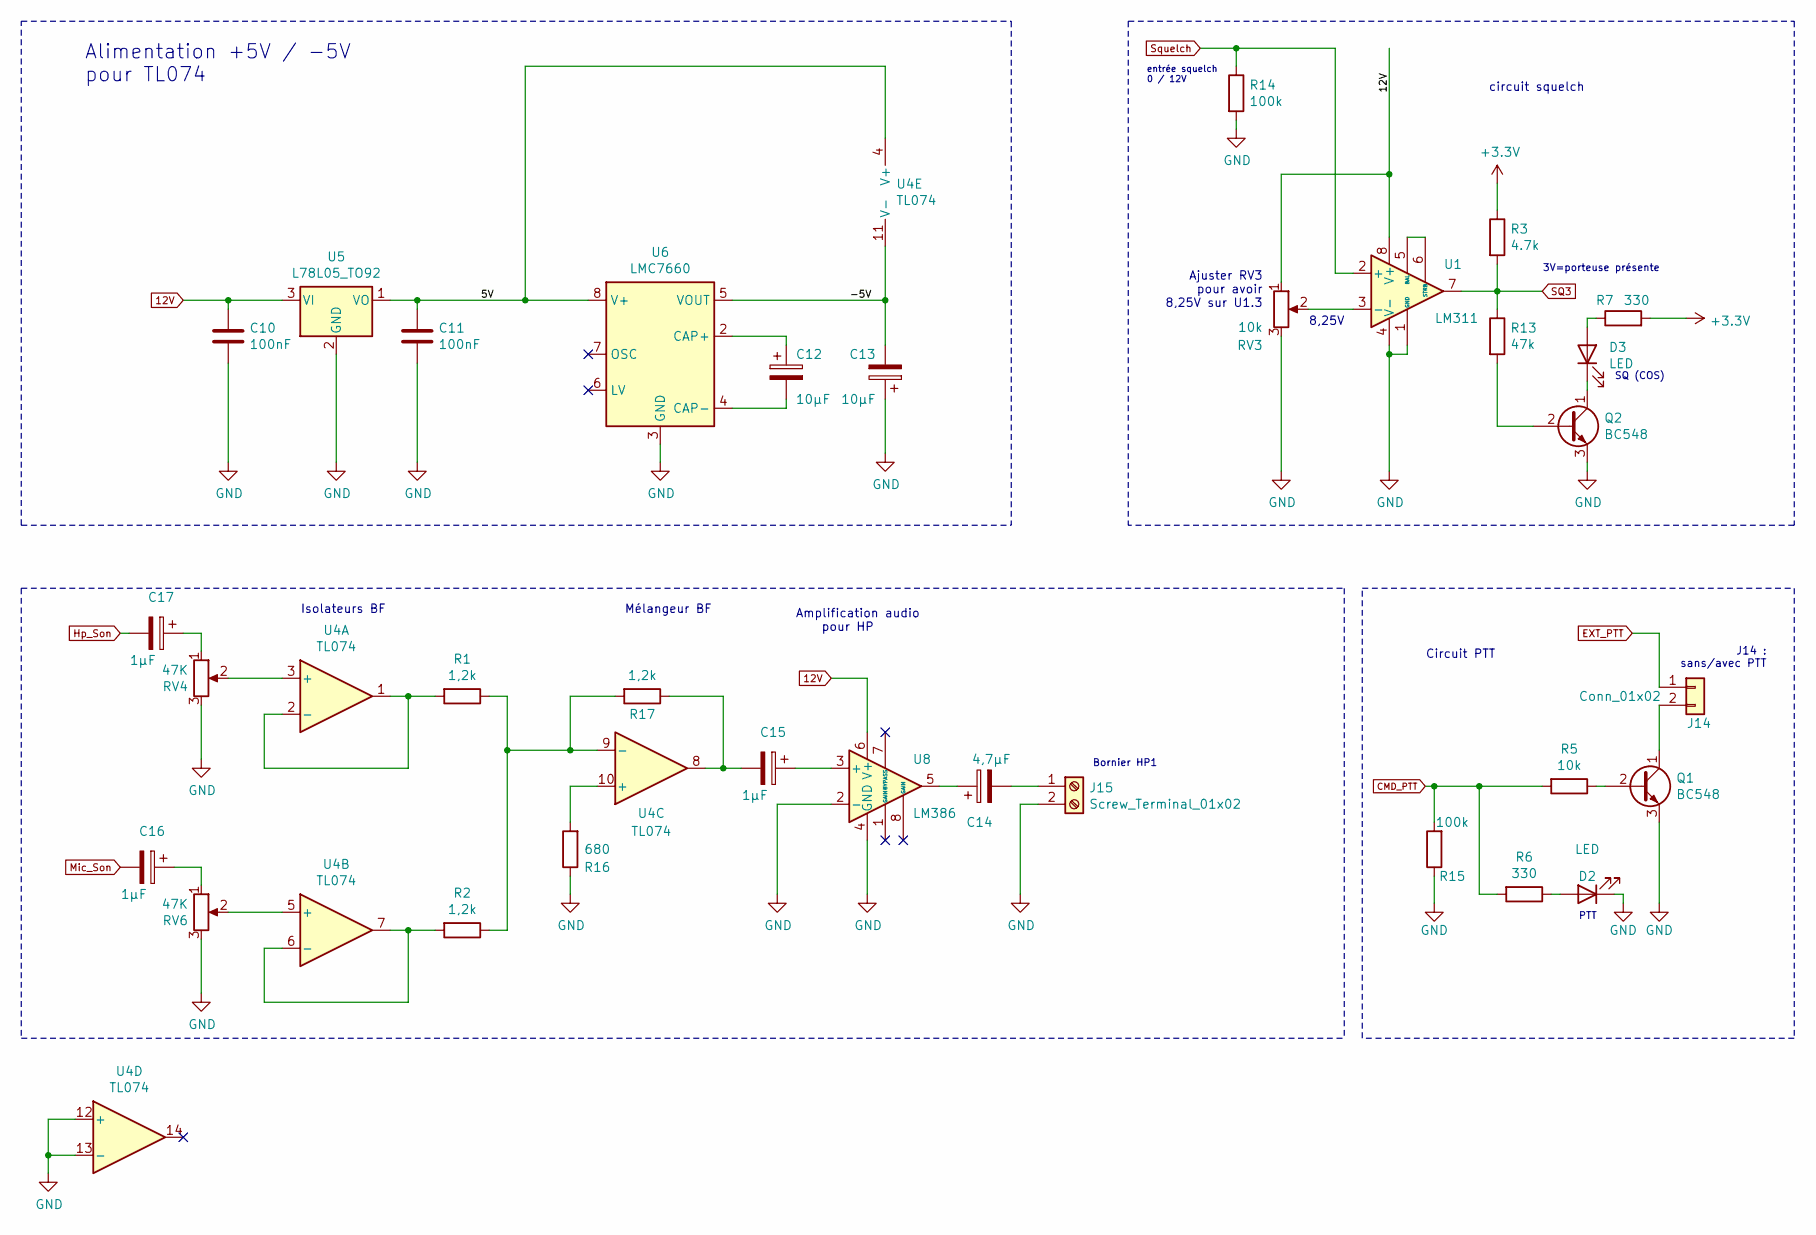
[picture p81: schematic Feuille2.sch, Interface Raspberry V4.1 - MTM800(E) MTM5x00 pour SVXLink]

Parts:
C10, C11: 100nF; C_Rect_L7.0mm_W2.5mm_P5.00mm
C12, C13: 10µF; CP_Radial_D4.0mm_P2.00mm
C14: 4,7µF; CP_Radial_D4.0mm_P2.00mm
C15, C16, C17: 1µF; CP_Radial_D4.0mm_P2.00mm
D2, D3: LED; LED_D3.0mm
J14: Conn_01x02; PinHeader_1x02_P2.54mm_Vertical
J15: Screw_Terminal_01x02; TerminalBlock_bornier-2_P5.08mm
Q1, Q2: BC548; TO-92_Inline_Wide
R1, R2, R17: 1,2k; R_Axial_DIN0207_L6.3mm_D2.5mm_P7.62mm_Horizontal
R3: 4.7k; R_Axial_DIN0207_L6.3mm_D2.5mm_P7.62mm_Horizontal
R5: 10k; R_Axial_DIN0207_L6.3mm_D2.5mm_P7.62mm_Horizontal
R6, R7: 330; R_Axial_DIN0207_L6.3mm_D2.5mm_P7.62mm_Horizontal
R13: 47k; R_Axial_DIN0207_L6.3mm_D2.5mm_P7.62mm_Horizontal
R14: 100k; R_Axial_DIN0204_L3.6mm_D1.6mm_P2.54mm_Vertical
R15: 100k; R_Axial_DIN0207_L6.3mm_D2.5mm_P7.62mm_Horizontal
R16: 680; R_Axial_DIN0207_L6.3mm_D2.5mm_P7.62mm_Horizontal
RV3: 10k; Potentiometer_Bourns_3296W_Vertical
RV4, RV6: 47K; Potentiometer_Bourns_3296W_Vertical
U1: LM311; DIP-8_W7.62mm_LongPads
U4: TL074; SOIC-14_3.9x8.7mm_P1.27mm
U5: L78L05_TO92; TO-92L_Inline_Wide
U6: LMC7660; SOIC-8_3.9x4.9mm_P1.27mm
U8: LM386; DIP-8_W7.62mm_LongPads

Connections:
12V: C10.1, RV3.1, U1.8 (V+), U5.3 (VI), U8.6 (V+); also elsewhere on the board
+3V3: R3.1, R7.2; also elsewhere on the board
/Feuille2/5V: C11.1, U4.4 (V+), U5.1 (VO), U6.8 (V+)
/Feuille2/-5V: C13.2, U4.11 (V-), U6.5 (VOUT)
CMD_PTT: R5.2, R6.2, R15.2; also elsewhere on the board
EXT_PTT: J14.1; also elsewhere on the board
GND: C10.2, C11.2, C13.1, D2.1 (K), J15.2, Q1.3 (E), Q2.3 (E), R14.2, R15.1, R16.1, RV3.3, RV4.3, RV6.3, U1.1 (GND), U1.4 (V-), U4.12 (+), U4.13 (-), U5.2 (GND), U6.3 (GND), U8.2 (-), U8.4 (GND); also elsewhere on the board
Mic_Son: C16.2; also elsewhere on the board
unnamed: C12.1, U6.2 (CAP+)
unnamed: C12.2, U6.4 (CAP-)
unnamed: C14.1, U8.5
unnamed: C14.2, J15.1
unnamed: C15.1, U8.3 (+)
unnamed: C15.2, R17.1, U4.8
unnamed: C16.1, RV6.1
unnamed: C17.1, RV4.1
unnamed: D2.2 (A), R6.1
unnamed: D3.1 (K), Q2.1 (C)
unnamed: D3.2 (A), R7.1
unnamed: J14.2, Q1.1 (C)
unnamed: Q1.2 (B), R5.1
unnamed: Q2.2 (B), R13.2
unnamed: R1.1, R2.1, R17.2, U4.9 (-)
unnamed: R1.2, U4.1, U4.2 (-)
unnamed: R2.2, U4.6 (-), U4.7
unnamed: R16.2, U4.10 (+)
unnamed: RV3.2, U1.3 (-)
unnamed: RV4.2, U4.3 (+)
unnamed: RV6.2, U4.5 (+)
unnamed: U1.5 (BAL), U1.6 (STRB)
SQ3: R3.2, R13.1, U1.7; also elsewhere on the board
Squelch: R14.1, U1.2 (+); also elsewhere on the board

Notes on the sheet:
Alimentation +5V / -5V pour TL074
Amplification audio pour HP
Bornier HP1
Mélangeur BF
Isolateurs BF
8,25V
3V=porteuse présente
SQ (COS)
Ajuster RV3 pour avoir 8,25V sur U1.3
circuit squelch
PTT
J14 : sans/avec PTT
Circuit PTT
entrée squelch 0 / 12V

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
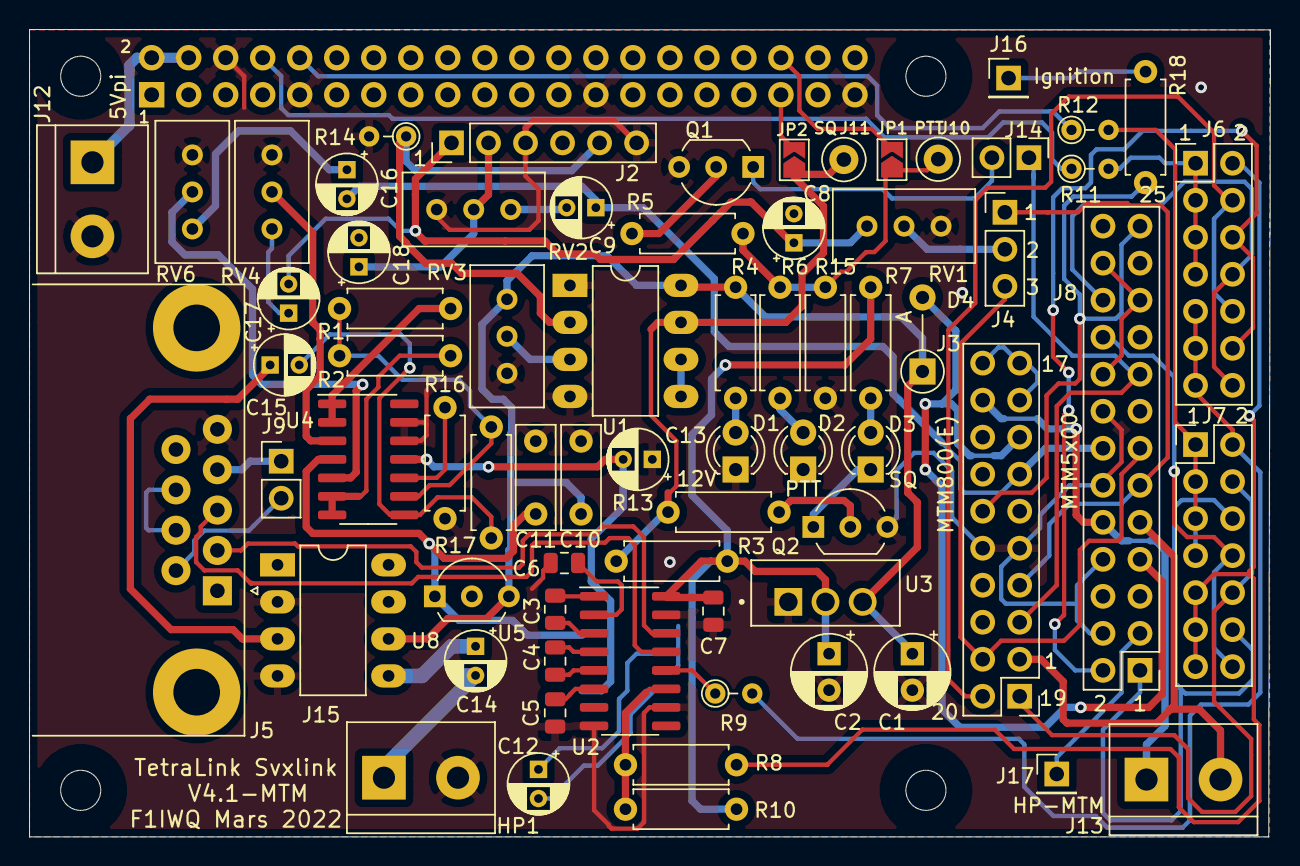
[picture p82: board interface_MTM800E_V4.kicad_pcb from above]

Board: 2 copper layers, 85.2 x 55.4 mm, 73 parts (1 on the bottom side), 75 nets.
